claudiusmarius/MusicBox01/PCB01.jpg

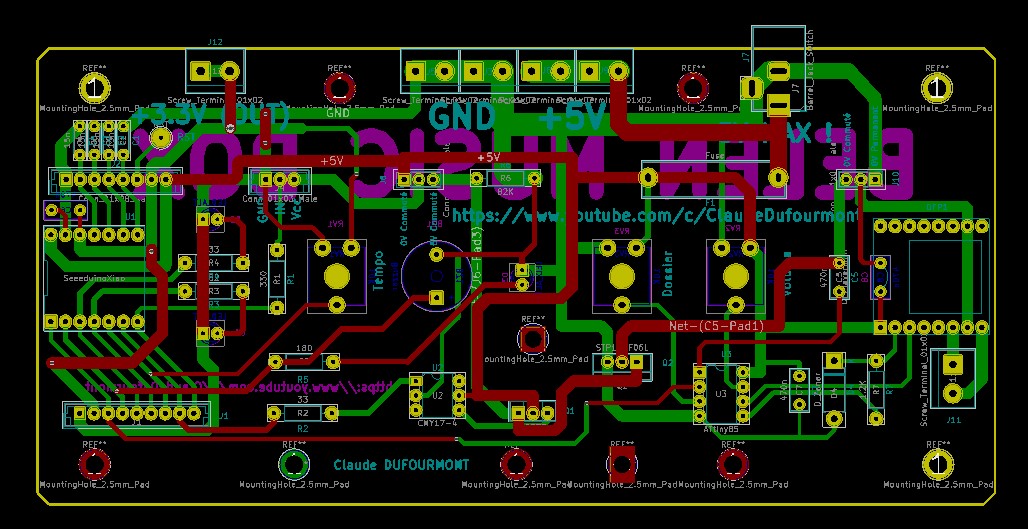
PCB01.jpg
