claudiusmarius/MusicBox01/README.md

# MusicBox01
Boîte à musique d'ambiance avec animation lumineuse
Vous trouverez ci-après toutes informations pour pouvoir réaliser vous même, cette boîte à musique avec scénarii lumineux.
Ce projet est basé sur l’utilisation des composants principaux suivants :
1 Seeeduino XIAO
1 ATtiny85
1 DFPlayer mini
4 Matrices 5x5 de LEDs adressables WS2812B
1 Optocoupleur CNY17-4
1 Transistor BJT NPN BD232
1 Transistor MOSFET canal N avec VGSth environ de 2,5V
J’ai fait réaliser le PCB par JLCPCB pour 5 pièces (commande minimale), le montant incluant la fabrication, le transport et les taxes s’élève à 23 euros. Par contre, j’ai fait en sorte que ce PCB puisse être utilisé dans d’autres applications.
Le fait de faire réaliser le PCB à l’aide des fichiers fournis dans les liens ci-dessous, a pour avantage de n’avoir pas la nécessité de percer et découper le PCB, il n’y a qu’à placer et souder les éléments
J’ai réalisé le boitier dans du FOREX (PVC Mousse) de 10 mm à l’aide de ma CNC3018, le résultat est bluffant.
ATTENTION : l'ATtiny85 est actuellement codé pour jouer 3 dossiers de musique MP3, l'intérieur de chaque dossier doit être sous le format suivant :
001.mp3
002.mp3
.... etc.
