claudiusmarius/MusicBox01/Printing Prévisualisation.pdf

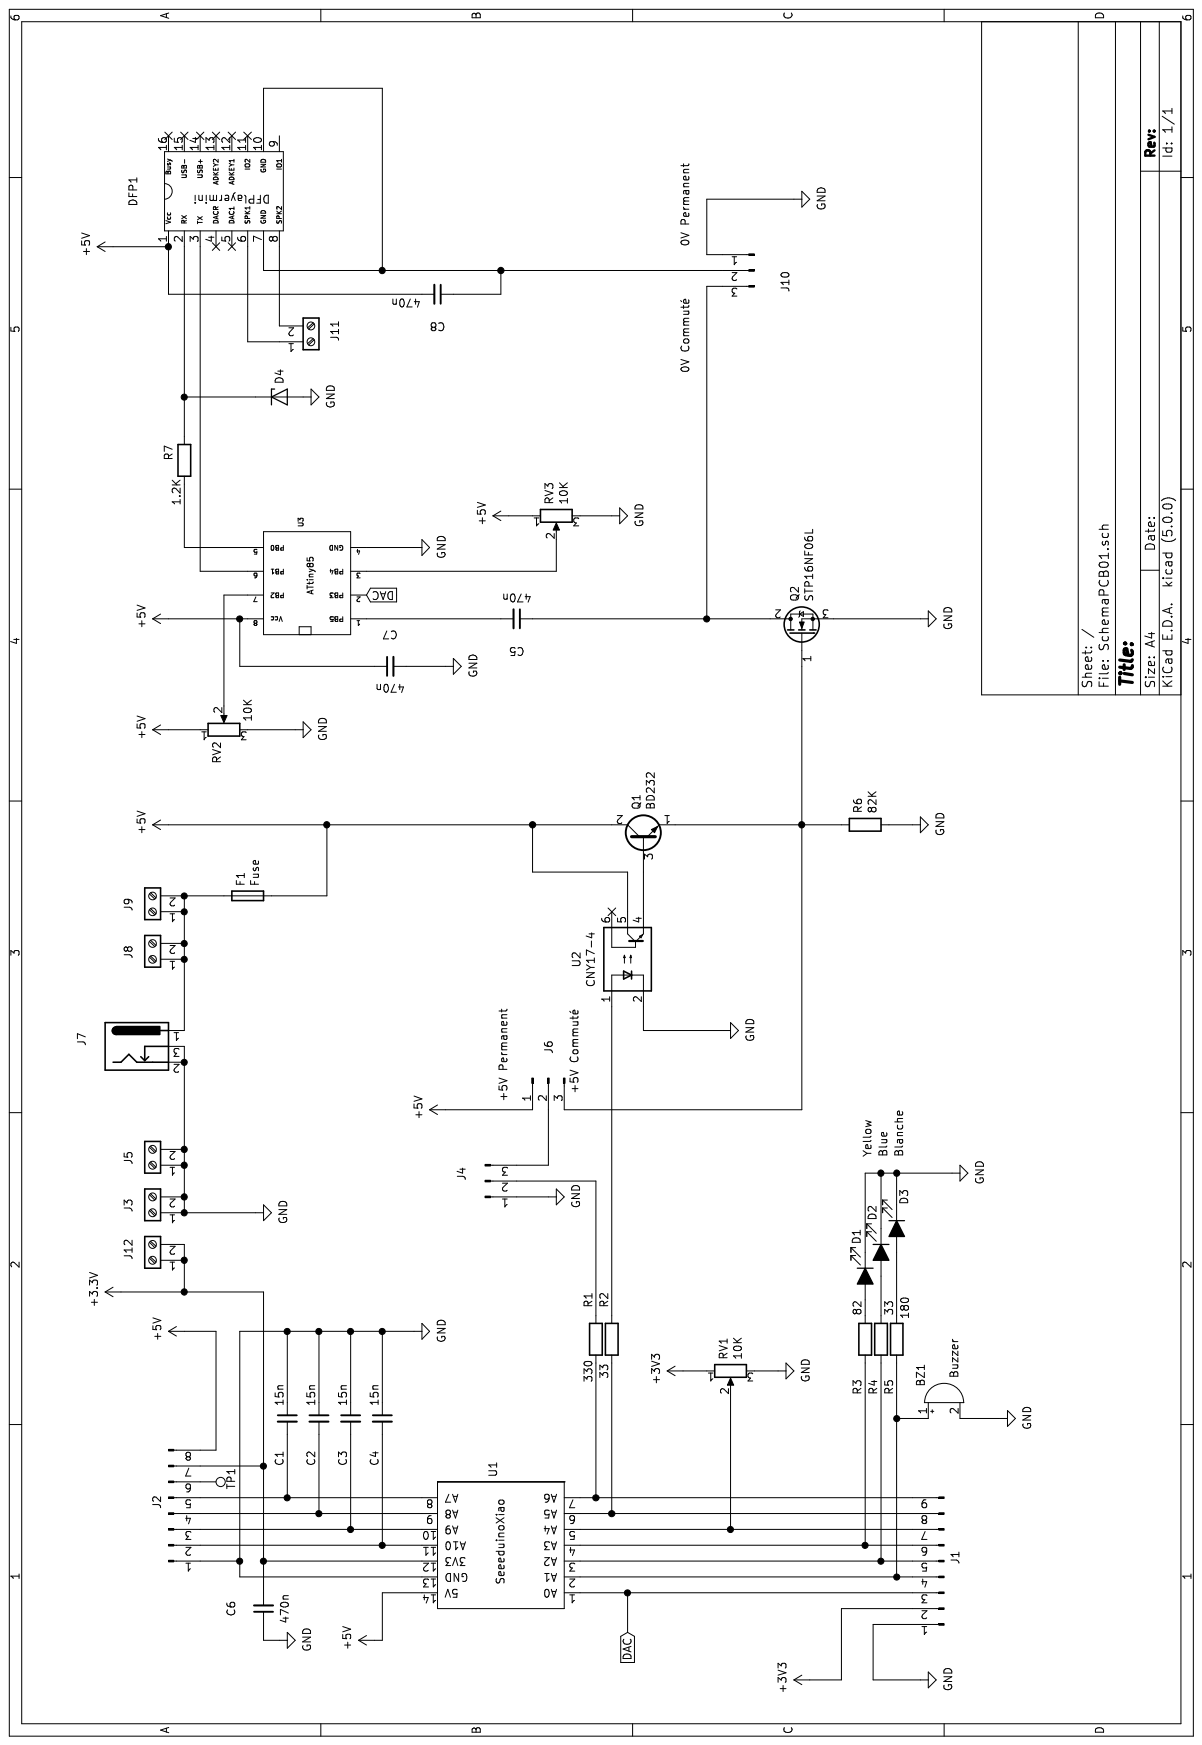
[picture p2: page 1]
